fmatray/why2025-badge/hardware/dragon-back.png

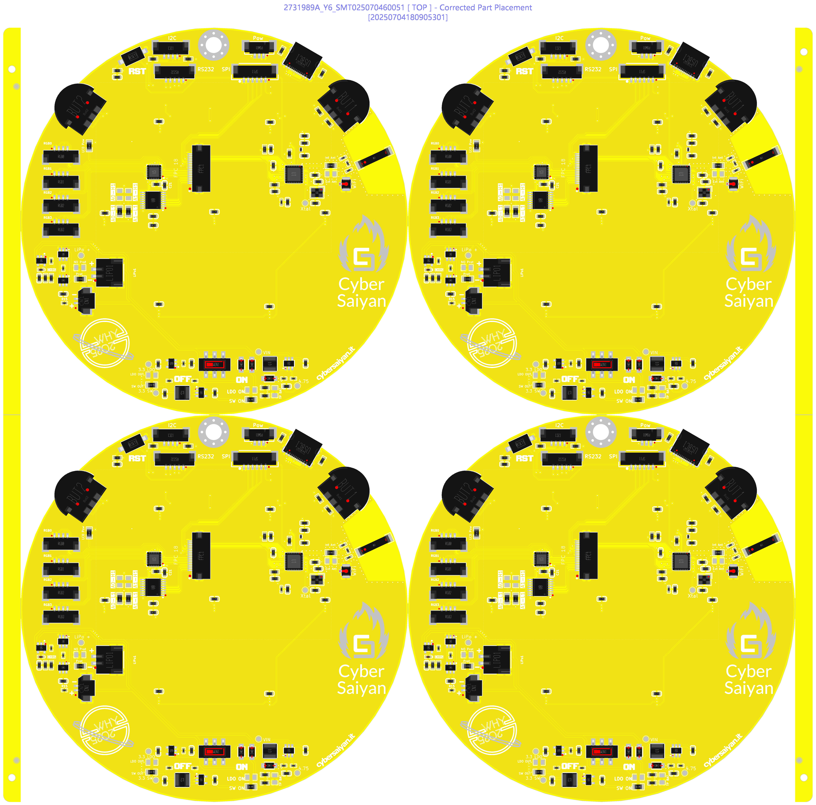
hardware/dragon-back.png
