fmatray/why2025-badge/hardware/dragon-front.png

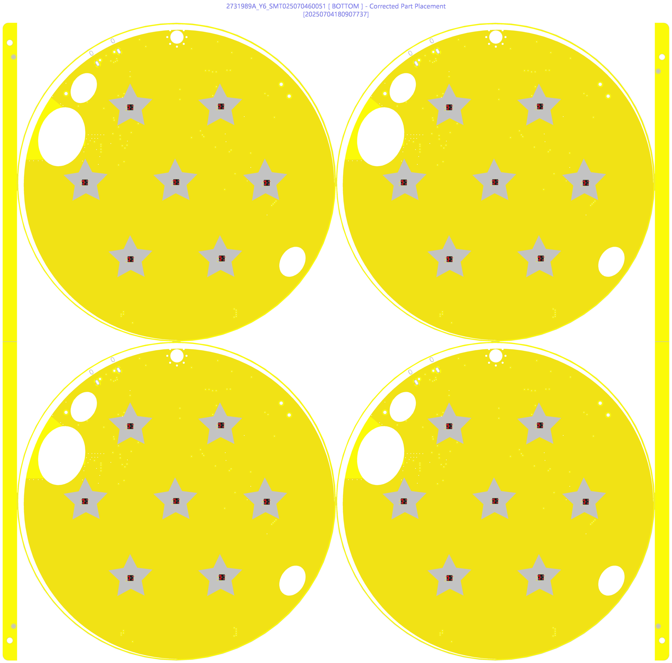
hardware/dragon-front.png
