fmatray/why2025-badge/hardware/dragon_4L_R02/dragon_4L_R02.kicad_pcb

## KiCad design hardware/dragon_4L_R02/dragon_4L_R02.kicad_pcb (2025-07-22)

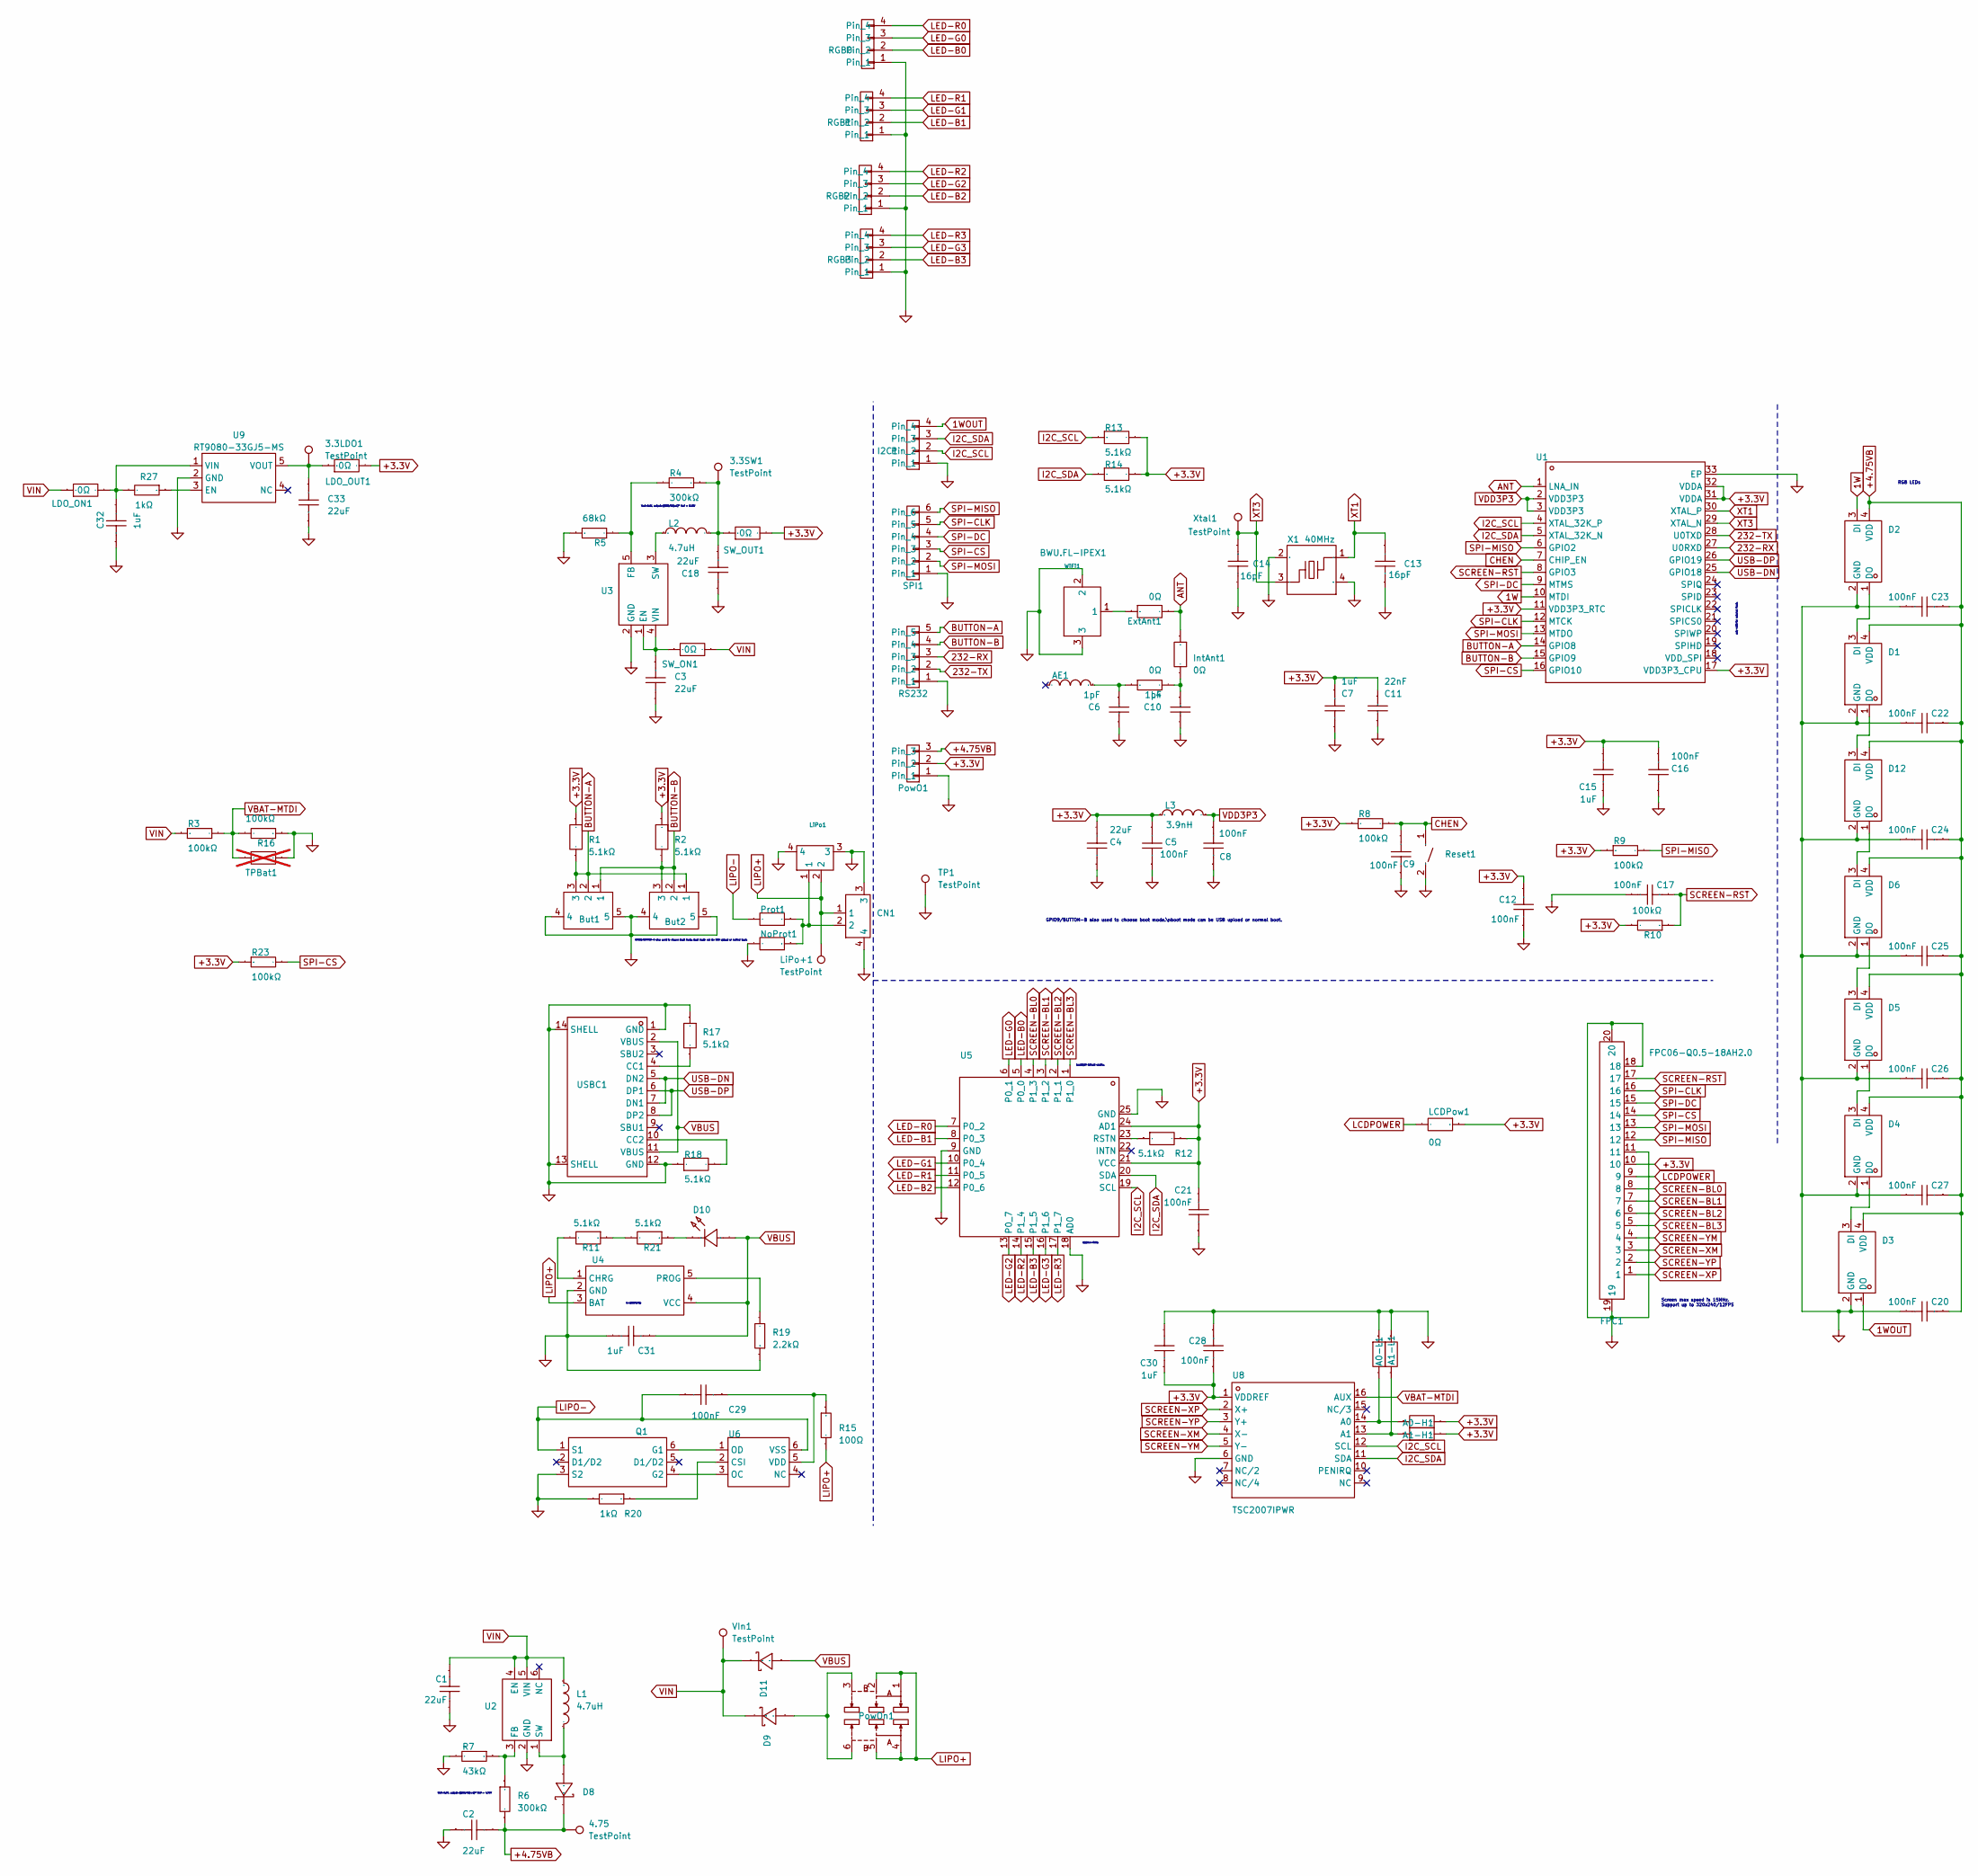
[picture p13: schematic dragon_4L_R02.kicad_sch]

Parts:
3.3LDO1, 3.3SW1, 4.75: TestPoint; TestPoint_Pad_D1.5mm
A0-H1, A0-L1, A1-H1, A1-L1: 0Ω; R0805; Manufacturer Part FRC0805P000 TS; LCSC Part Name 0Ω ±5% 125mW 厚膜电阻
AE1: AN9520-245; ANT-SMD_L9.5-W2.1; Manufacturer Part AN9520-245; LCSC Part Name AN9520-245
But1, But2: QS-301-AGS5P; SW-SMD_QS-301-AGS5P; Manufacturer Part QS-301-AGS5P; LCSC Part Name 三脚 大头拨轮多功能开关 MP3/MP4换曲按键
C1, C2, C3, C4, C18, C33: 22uF; C0603; Manufacturer Part CL10A226MQ8NRNC; LCSC Part Name 22uF ±20% 6.3V
C5, C8, C9, C12, C16, C17, C20, C21, C22, C23, C24, C25, C26, C27, C28, C29: 100nF; C0603; Manufacturer Part FCC0603B104K500CT; LCSC Part Name 100nF ±10% 50V
C6, C10: 1pF; C0402; Manufacturer Part GJM1555C1H1R0WB01D; LCSC Part Name 1pF 50V ±0.05pF
C7, C15, C30, C31, C32: 1uF; C0603; Manufacturer Part CGA0603X5R105K160JT; LCSC Part Name 1uF ±10% 16V
C11: 22nF; C0402; Manufacturer Part CC0402KRX7R9BB223; LCSC Part Name 22nF ±10% 50V
C13, C14: 16pF; C0603; Manufacturer Part CC0603JRNPO9BN160; LCSC Part Name 16pF ±5% 50V
CN1: HCZZ0001-2; CONN-SMD_2P-P1.25_HC_HCZZ0001-2; Manufacturer Part HCZZ0001-2; LCSC Part Name 米色 1x2P 间距:1.25mm 卧贴 系列:PicoBlade(MX 1.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
D1, D2, D3, D4, D5, D6, D12: WS2812B-2020; LED-SMD_4P-L2.0-W2.0-TL_WS2812B-2020; Manufacturer Part WS2812B-2020; LCSC Part Name RGB三色
D8, D9, D11: CRS08(TE85L,Q,M); SOD-123_L2.8-W1.8-LS3.7-FD; Manufacturer Part CRS08(TE85L,Q,M); LCSC Part Name 电压:30V 电流:1.5A
D10: XL-1005UGC; LED0402-RD_GREEN; Manufacturer Part XL-1005UGC; LCSC Part Name XL-1005UGC
ExtAnt1: 0Ω; R0805; Manufacturer Part FRC0805P000 TS; LCSC Part Name 0Ω ±5% 125mW 厚膜电阻
FPC1: FPC06-Q0.5-18AH2.0; FPC-SMD_18P-P0.50_FPC06-Q0.5-18AH2.0; Manufacturer Part FPC06-Q0.5-18AH2.0; LCSC Part Name 间距:0.5mm P数:18P 翻盖式 下接
I2C1: HCZZ0015-4; CONN-SMD_4P-P1.25_HCZZ0015-4; Manufacturer Part HCZZ0015-4; LCSC Part Name 米色 1x4P 间距:1.25mm 立贴闭口不加盖 系列:PicoBlade(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
IntAnt1: 0Ω; R0805; Manufacturer Part FRC0805P000 TS; LCSC Part Name 0Ω ±5% 125mW 厚膜电阻
L1, L2: 4.7uH; IND-SMD_L4.0-W4.0_FNR40XXS; Manufacturer Part FNR4030S4R7MT; LCSC Part Name 4.7uH ±20% 3.2A
L3: 3.9nH; IND-SMD_L1.0-W0.5-2; Manufacturer Part LQW15AN3N9B00D; LCSC Part Name 3.9nH
L4: 0Ω; R0402; Manufacturer Part 0402WGF0000TCE; LCSC Part Name 0Ω ±1% 62.5mW 厚膜电阻
LCDPow1: 0Ω; R0805; Manufacturer Part FRC0805P000 TS; LCSC Part Name 0Ω ±5% 125mW 厚膜电阻
LDO_ON1: 0Ω; R0805; Manufacturer Part FRC0805P000 TS; LCSC Part Name 0Ω ±5% 125mW 厚膜电阻
LDO_OUT1: 0Ω; R0805; Manufacturer Part FRC0805P000 TS; LCSC Part Name 0Ω ±5% 125mW 厚膜电阻
LiPo1: BX-PH2.0-2PWT; CONN-SMD_2P-P2.00_BX-PH2.0-2PWT; Manufacturer Part BX-PH2.0-2PWT; LCSC Part Name 1x2P 间距:2mm 卧贴 系列:PH
LiPo+1: TestPoint; TestPoint_Pad_D1.5mm
NoProt1: 0Ω; R0805; Manufacturer Part FRC0805P000 TS; LCSC Part Name 0Ω ±5% 125mW 厚膜电阻
PowO1: HCZZ0015-3; CONN-SMD_3P-P1.25-L3.3-W8.8; Manufacturer Part HCZZ0015-3; LCSC Part Name 米色 1x3P 间距:1.25mm 立贴闭口不加盖 系列:PicoBlade(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
PowOn1: MST22D18G2 125; SW-SMD_MST22D18G2; Manufacturer Part MST22D18G2 125; LCSC Part Name 拨动开关/两档立式 6脚贴片 柄长2.0mm 大六立贴 9.1*3.5mm
Prot1: 0Ω; R0805; Manufacturer Part FRC0805P000 TS; LCSC Part Name 0Ω ±5% 125mW 厚膜电阻
Q1: HJ8205; SOT-23-6_L2.9-W1.6-P0.95-LS2.8-BR; Manufacturer Part HJ8205; LCSC Part Name 1个N沟道 耐压:20V 电流:4.3A
R1, R2, R11, R12, R13, R14, R17, R18, R21: 5.1kΩ; R0603; Manufacturer Part SCR0603F5K1; LCSC Part Name 厚膜电阻 5.1kΩ ±1% 100mW
R3, R8, R9, R10, R16, R23: 100kΩ; R0603; Manufacturer Part RC0603FR-07100KL; LCSC Part Name 厚膜电阻 100kΩ ±1% 100mW
R4, R6: 300kΩ; R0402; Manufacturer Part RC0402FR-07300KL; LCSC Part Name 厚膜电阻 300kΩ ±1% 62.5mW
R5: 68kΩ; R0402; Manufacturer Part RC0402FR-0768KL; LCSC Part Name 厚膜电阻 68kΩ ±1% 62.5mW
R7: 43kΩ; R0402; Manufacturer Part RC0402FR-0743KL; LCSC Part Name 厚膜电阻 43kΩ ±1% 62.5mW
R15: 100Ω; R0402; Manufacturer Part 0402WGF1000TCE; LCSC Part Name 100Ω ±1% 62.5mW 厚膜电阻
R19: 2.2kΩ; R0402; Manufacturer Part RMC04022.2K1%N; LCSC Part Name 2.2kΩ ±1% 62.5mW
R20, R27: 1kΩ; R0402; Manufacturer Part 0402WGF1001TCE; LCSC Part Name 1kΩ ±1% 62.5mW 厚膜电阻
RGB0, RGB1, RGB2, RGB3: HCZZ0015-4; CONN-SMD_4P-P1.25_HCZZ0015-4; Manufacturer Part HCZZ0015-4; LCSC Part Name 米色 1x4P 间距:1.25mm 立贴闭口不加盖 系列:PicoBlade(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
RS232: HCZZ0015-5; CONN-SMD_5P-P1.25_HCZZ0015-5; Manufacturer Part HCZZ0015-5; LCSC Part Name 米色 1x5P 间距:1.25mm 立贴闭口不加盖 系列:PicoBlade(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
Reset1: TSB008A2526A; SW-SMD_L6.0-W3.5-LS8.0; Manufacturer Part TSB008A2526A; LCSC Part Name 新一型3*6*2.5H-YL 260gf 白钮
SPI1: HCZZ0015-6; CONN-SMD_6P-P1.25_HCZZ0015-6; Manufacturer Part HCZZ0015-6; LCSC Part Name 米色 1x6P 间距:1.25mm 立贴闭口不加盖 系列:PicoBlade(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
SW_ON1: 0Ω; R0805; Manufacturer Part FRC0805P000 TS; LCSC Part Name 0Ω ±5% 125mW 厚膜电阻
SW_OUT1: 0Ω; R0805; Manufacturer Part FRC0805P000 TS; LCSC Part Name 0Ω ±5% 125mW 厚膜电阻
TP1: TestPoint; MountingHole_4.5mm_Pad_Via
TPBat1: 0Ω; R0805; Manufacturer Part FRC0805P000 TS; LCSC Part Name 0Ω ±5% 125mW 厚膜电阻; not fitted
U1: ESP32-C3FH4; QFN-32_L5.0-W5.0-P0.50-TL-EP3.7; Manufacturer Part ESP32-C3FH4; LCSC Part Name ESP32-C3FH4
U2: MT3608B; SOT-23-6_L2.9-W1.6-P0.95-LS2.8-BR; Manufacturer Part MT3608B; LCSC Part Name 高效1.2MHz升压转换器
U3: MT3410LB-N; SOT-23-5_L3.0-W1.5-P0.95-LS2.8-BL; Manufacturer Part MT3410LB-N; LCSC Part Name MT3410LB-N
U4: TP4054; SOT-23-5_L2.9-W1.6-P0.95-LS2.8-BR; Manufacturer Part TP4054; LCSC Part Name TP4054
U5: AW9523BTQR; VFQFPN-24_L4.0-W4.0-P0.50-BL-EP2.8; Manufacturer Part AW9523BTQR; LCSC Part Name AW9523B产品手册
U6: DW01A; SOT-23-6_L2.9-W1.6-P0.95-LS2.8-BL; Manufacturer Part DW01A; LCSC Part Name DW01A
U8: TSC2007IPWR; TSSOP-16_L5.0-W4.4-P0.65-LS6.4-BL; Manufacturer Part TSC2007IPWR; LCSC Part Name TSC2007 触摸屏控制器
U9: RT9080-33GJ5-MS; SOT-23-5_L2.9-W1.6-P0.95-LS2.8-BR; Manufacturer Part RT9080-33GJ5-MS; LCSC Part Name RT9080-33GJ5-MS
USBC1: TYPE-C 16PIN 2MD(073); USB-C-SMD_TYPE-C-6PIN-2MD-073; Manufacturer Part TYPE-C 16PIN 2MD(073); LCSC Part Name Type-C 母 卧贴
VIn1: TestPoint; TestPoint_Pad_D1.5mm
WiFi1: BWU.FL-IPEX1; IPEX-SMD_BWIPX-1-001E; Manufacturer Part BWU.FL-IPEX1; LCSC Part Name 内针 IPEX
X1: 40MHz; CRYSTAL-SMD_4P-L3.2-W2.5-BL; Manufacturer Part L327S400H11L; LCSC Part Name 40MHz ±10ppm 10pF
Xtal1: TestPoint; TestPoint_Pad_D1.5mm

Connections:
1W: D2.3 (DI), U1.10 (MTDI)
1WOUT: D3.1 (DO), I2C1.4
232-RX: RS232.3, U1.27 (U0RXD)
232-TX: RS232.2, U1.28 (U0TXD)
+3.3V: A0-H1.2, A1-H1.2, C4.2, C5.2, C7.1, C11.1, C12.1, C15.2, C16.2, C21.2, C28.2, C30.1, FPC1.10, L3.1, LCDPow1.1, LDO_OUT1.2, PowO1.2, R1.1, R2.1, R8.1, R9.1, R10.2, R12.2, R13.2, R14.2, R23.1, SW_OUT1.2, U1.11 (VDD3P3_RTC), U1.17 (VDD3P3_CPU), U1.31 (VDDA), U1.32 (VDDA), U5.21 (VCC), U5.24 (AD1), U8.1 (VDDREF)
+4.75VB: 4.75.1, C2.2, C20.1, C22.1, C23.1, C24.1, C25.1, C26.1, C27.1, D1.4 (VDD), D2.4 (VDD), D3.4 (VDD), D4.4 (VDD), D5.4 (VDD), D6.4 (VDD), D8.2 (K), D12.4 (VDD), PowO1.3, R6.2
ANT: ExtAnt1.2, IntAnt1.1, U1.1 (LNA_IN)
BUTTON-A: But1.2, But1.3, But2.1, R1.2, RS232.5, U1.14 (GPIO8)
BUTTON-B: But1.1, But2.2, But2.3, R2.2, RS232.4, U1.15 (GPIO9)
CHEN: C9.2, R8.2, Reset1.1, U1.7 (CHIP_EN)
I2C_SCL: I2C1.2, R13.1, U1.4 (XTAL_32K_P), U5.19 (SCL), U8.12 (SCL)
I2C_SDA: I2C1.3, R14.1, U1.5 (XTAL_32K_N), U5.20 (SDA), U8.11 (SDA)
LCDPOWER: FPC1.9, LCDPow1.2
LED-B0: RGB0.2, U5.5 (P0_0)
LED-B1: RGB1.2, U5.8 (P0_3)
LED-B2: RGB2.2, U5.12 (P0_6)
LED-B3: RGB3.2, U5.15 (P1_5)
LED-G0: RGB0.3, U5.6 (P0_1)
LED-G1: RGB1.3, U5.10 (P0_4)
LED-G2: RGB2.3, U5.13 (P0_7)
LED-G3: RGB3.3, U5.16 (P1_6)
LED-R0: RGB0.4, U5.7 (P0_2)
LED-R1: RGB1.4, U5.11 (P0_5)
LED-R2: RGB2.4, U5.14 (P1_4)
LED-R3: RGB3.4, U5.17 (P1_7)
LIPO+: CN1.1, LiPo1.2, LiPo+1.1, PowOn1.1, PowOn1.2, PowOn1.4, PowOn1.5, R15.2, U4.3 (BAT)
LIPO-: C29.2, Prot1.2, Q1.1 (S1), U6.6 (VSS)
unnamed: 3.3SW1.1, C18.1, L2.2, R4.1, SW_OUT1.1
unnamed: AE1.1, C6.1, L4.1
unnamed: C10.1, IntAnt1.2, L4.2
unnamed: CN1.2, LiPo1.1, NoProt1.1, Prot1.1
unnamed: D1.3 (DI), D2.1 (DO)
unnamed: D1.1 (DO), D12.3 (DI)
unnamed: D3.3 (DI), D4.1 (DO)
unnamed: D4.3 (DI), D5.1 (DO)
unnamed: D5.3 (DI), D6.1 (DO)
unnamed: D8.1 (A), L1.2, U2.1 (SW)
unnamed: D9.1 (A), PowOn1.3, PowOn1.6
unnamed: D10.1 (K), R21.1
unnamed: D6.3 (DI), D12.1 (DO)
unnamed: ExtAnt1.1, WiFi1.1
unnamed: Q1.6 (G1), U6.1 (OD)
unnamed: Q1.4 (G2), U6.3 (OC)
unnamed: R11.1, R21.2
unnamed: R6.1, R7.1, U2.3 (FB)
unnamed: C3.1, SW_ON1.1, U3.1 (EN), U3.4 (VIN)
unnamed: R4.2, R5.2, U3.5 (FB)
unnamed: L2.1, U3.3 (SW)
unnamed: R11.2, U4.1 (CHRG)
unnamed: R19.2, U4.5 (PROG)
unnamed: R12.1, U5.23 (RSTN)
unnamed: R20.1, U6.2 (CSI)
unnamed: C29.1, R15.1, U6.5 (VDD)
unnamed: A0-H1.1, A0-L1.2, U8.14 (A0)
unnamed: A1-H1.1, A1-L1.2, U8.13 (A1)
unnamed: R27.1, U9.3 (EN)
unnamed: C32.2, LDO_ON1.2, R27.2, U9.1 (VIN)
unnamed: 3.3LDO1.1, C33.2, LDO_OUT1.1, U9.5 (VOUT)
unnamed: R17.2, USBC1.4 (CC1)
unnamed: R18.2, USBC1.10 (CC2)
POWER_GND: A0-L1.1, A1-L1.1, But1.4, But1.5, But2.4, But2.5, C1.2, C2.1, C3.2, C4.1, C5.1, C6.2, C7.2, C8.1, C9.1, C10.2, C11.2, C12.2, C13.1, C14.2, C15.1, C16.1, C17.2, C18.2, C20.2, C21.1, C22.2, C23.2, C24.2, C25.2, C26.2, C27.2, C28.1, C30.2, C31.2, C32.1, C33.1, CN1.3, CN1.4, D1.2 (GND), D2.2 (GND), D3.2 (GND), D4.2 (GND), D5.2 (GND), D6.2 (GND), D12.2 (GND), FPC1.11, FPC1.18, FPC1.19, FPC1.20, I2C1.1, LiPo1.3, LiPo1.4, NoProt1.2, PowO1.1, Q1.3 (S2), R5.1, R7.2, R16.1, R17.1, R18.1, R19.1, R20.2, RGB0.1, RGB1.1, RGB2.1, RGB3.1, RS232.1, Reset1.2, SPI1.1, TP1.1, TPBat1.1, U1.33 (EP), U2.2 (GND), U3.2 (GND), U4.2 (GND), U5.9 (GND), U5.18 (AD0), U5.25 (GND), U8.6 (GND), U9.2 (GND), USBC1.1 (GND), USBC1.12 (GND), USBC1.13 (SHELL), USBC1.14 (SHELL), WiFi1.2, WiFi1.3, X1.2 (GND), X1.4 (GND)
SCREEN-BL0: FPC1.8, U5.4 (P1_3)
SCREEN-BL1: FPC1.7, U5.3 (P1_2)
SCREEN-BL2: FPC1.6, U5.2 (P1_1)
SCREEN-BL3: FPC1.5, U5.1 (P1_0)
SCREEN-RST: C17.1, FPC1.17, R10.1, U1.8 (GPIO3)
SCREEN-XM: FPC1.3, U8.4 (X-)
SCREEN-XP: FPC1.1, U8.2 (X+)
SCREEN-YM: FPC1.4, U8.5 (Y-)
SCREEN-YP: FPC1.2, U8.3 (Y+)
SPI-CLK: FPC1.16, SPI1.5, U1.12 (MTCK)
SPI-CS: FPC1.14, R23.2, SPI1.3, U1.16 (GPIO10)
SPI-DC: FPC1.15, SPI1.4, U1.9 (MTMS)
SPI-MISO: FPC1.12, R9.2, SPI1.6, U1.6 (GPIO2)
SPI-MOSI: FPC1.13, SPI1.2, U1.13 (MTDO)
USB-DN: U1.25 (GPIO18), USBC1.5 (DN2), USBC1.7 (DN1)
USB-DP: U1.26 (GPIO19), USBC1.6 (DP1), USBC1.8 (DP2)
VBAT-MTDI: R3.2, R16.2, TPBat1.2, U8.16 (AUX)
VBUS: C31.1, D10.2 (A), D11.1 (A), U4.4 (VCC), USBC1.2 (VBUS), USBC1.11 (VBUS)
VDD3P3: C8.2, L3.2, U1.2 (VDD3P3), U1.3 (VDD3P3)
VIN: C1.1, D9.2 (K), D11.2 (K), L1.1, LDO_ON1.1, R3.1, SW_ON1.2, U2.4 (EN), U2.5 (VIN), VIn1.1
XT1: C13.2, U1.30 (XTAL_P), X1.1
XT3: C14.1, U1.29 (XTAL_N), X1.3, Xtal1.1

Notes on the sheet:
only valid for external flash.
Vref=0.6V, output=((300/43)+1)* Vref = 4.78V
Vref=0.6V, output=((300/68)+1)* Vref = 3.25V
RGB LEDs
Ic=1000V/Rp
GPIO9/BUTTON-B also used to choose boot mode.\nboot mode can be USB upload or normal boot.
backlight default enable.
GPIO9/BUTTON-B also used to choose boot mode. boot mode can be USB upload or normal boot.
address=0x5a
Screen max speed is 15MHz. Support up to 320x240/12FPS

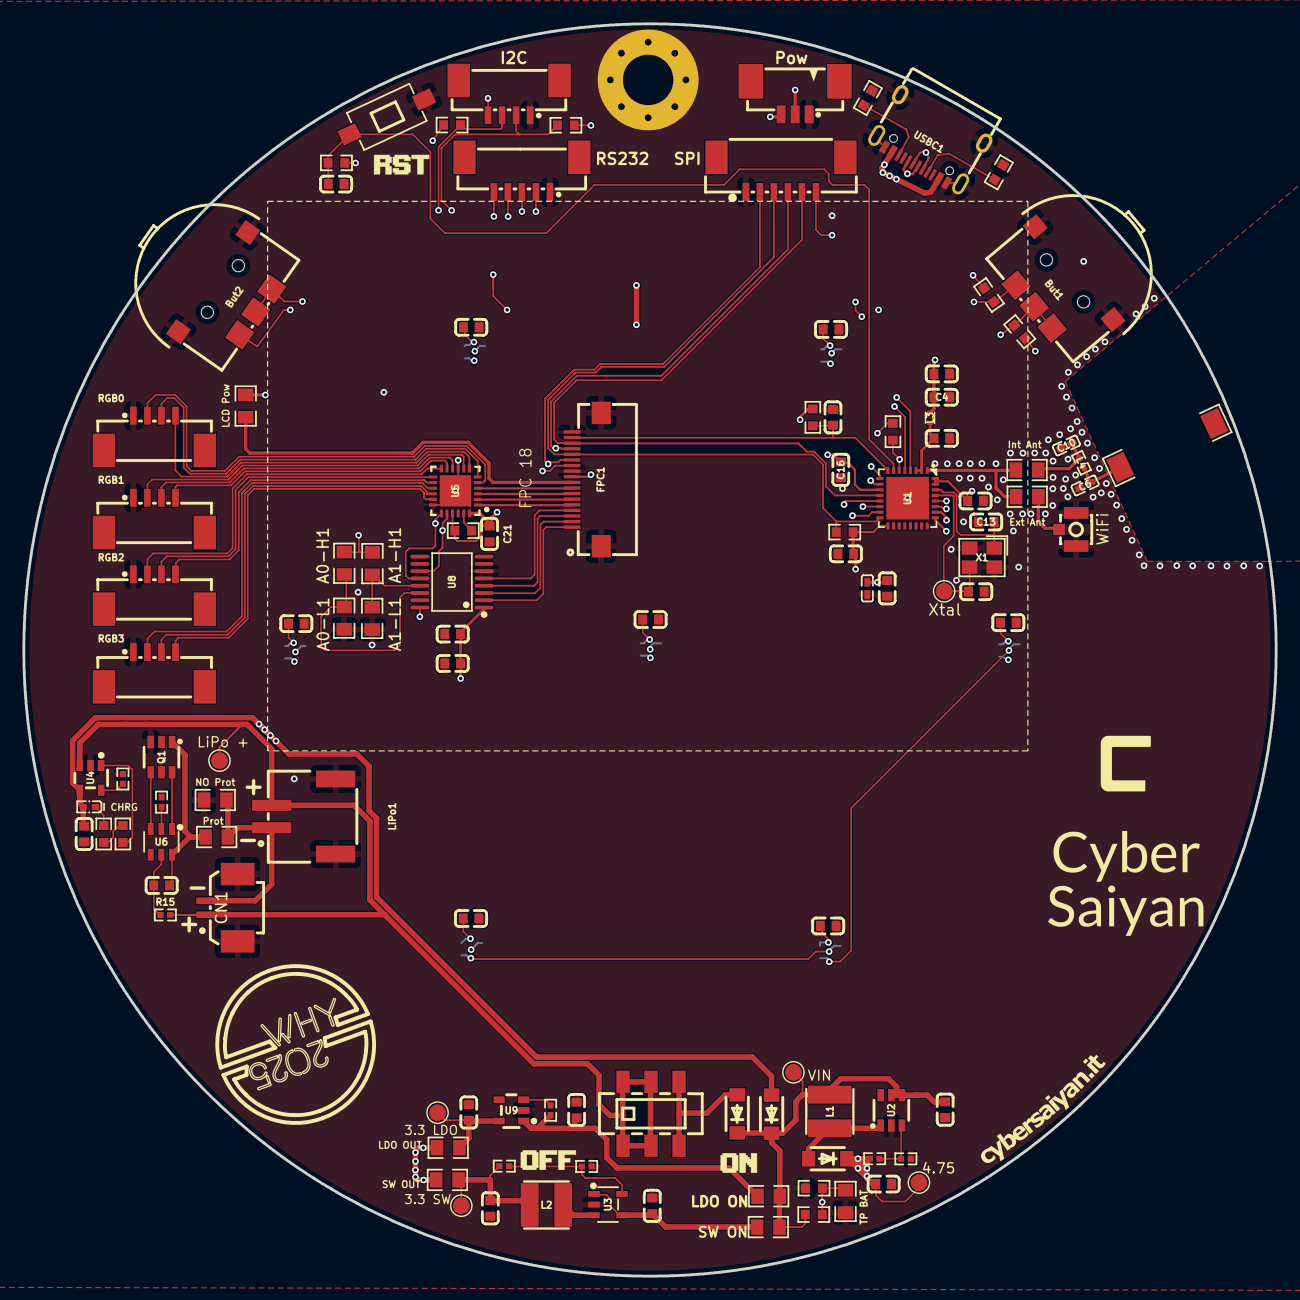
[picture p14: board dragon_4L_R02.kicad_pcb from above]

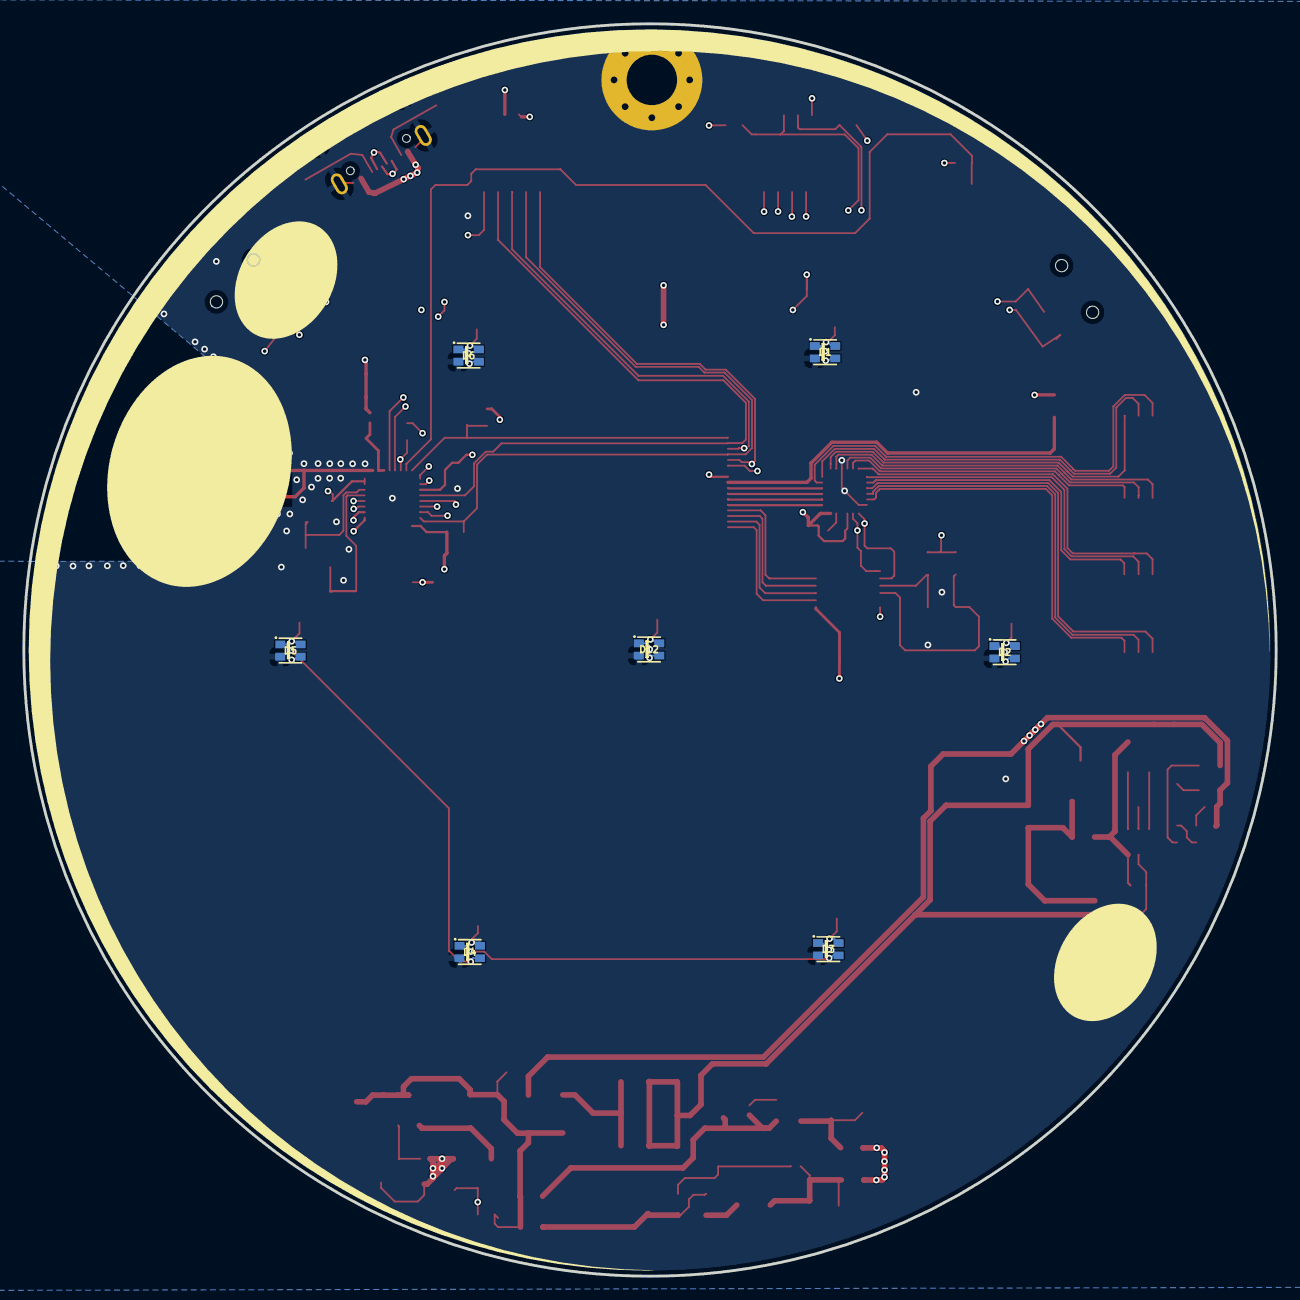
[picture p15: board dragon_4L_R02.kicad_pcb from below]

Board: 4 copper layers, 111.8 x 111.8 mm, 127 parts (9 on the bottom side), 83 nets.

Other parts of the board:
BALL**: Ball; RH_BALL
LOGO***: Logo; CS_LOGO
OFF**: Off; CS_OFF
ON**: On; CS_ON
RST**: Rst; CS_RST
STAR**: Star; CS_STAR
WEB**: Website; CS_WEBSITE
WHY***: LOGO; WHY_LOGO
