fmatray/why2025-badge/(commit log)

2025-07-22 First commit for WHY2025 badge
    [BOM-dragon_4L_R02.csv, dragon_4L_R02.kicad_pcb, dragon_4L_R02.kicad_sch, partitions.csv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]
2025-07-26 Fix wifi to connect to open wifi networks Configured connection to WHY2025-open network (see https://wiki.why2025.org/Network#Wireless)
    [wifi.c]
2025-08-04 Fix missing null-terminating the string In the load_schedule_from_file function, after allocating memory with malloc(file_size + 1) and reading the file content with fread(), the function is missing 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
    The buffer is not being null-terminated, which means when the JSON string is sent to the client, it may contain garbage data at the end, making it invalid JSON that cannot be parsed by the browser.
    [badge.c]
2025-08-04 Fix SSL memory allocation error (MBEDTLS_ERR_SSL_ALLOC_FAILED)
    - Reduce SSL buffer sizes from 16KB/4KB to 8KB/2KB
    - Enable dynamic SSL buffer allocation
    - Add memory checks before attempting SSL connections
    - Limit HTTP client buffer sizes
    - Improve error handling and cleanup
    - Add heap memory logging for debugging
    Fixes 'mbedtls_ssl_setup returned -0x7F00' error during HTTPS sync
    [sync.c]
2025-08-05 Fix mobile radar display: make Dragon Ball radar responsive
    - Add mobile-responsive CSS for radar display on phones
    - Reduce radar size from 360px to 280px on tablets (≤760px)
    - Further reduce to 240px on small phones (≤480px)
    - Add proper centering with auto margins and text-align center
    - Update HTML responsive classes for better mobile layout
    - Maintain Dragon Ball radar styling and animations
    - Fix radar being too big and not centered on mobile devices
2025-08-05 Fix LED collision between easter eggs and normal flashing
    - Add easter_egg_active flag to prevent LED task interference
    - Block normal LED flashing during rainbow() and set_completed() execution
    - Add set_easter_egg_active() function to control the blocking mechanism
    - Ensure easter eggs run without interruption from the LED task
    - LED task now checks easter_egg_active flag and waits when easter eggs are running
    Closes #13
    [led.c, led.h]
2025-08-09 Fix backlight Enhance the backlight brightness
    [led.c]
